Y2K-x/OpeN64-Ultra/(commit log)

2026-03-28 correct non-schematic parity DRC errors
    [OpeN64.kicad_sch]
2026-03-28 Start schematic rework - recreate RDRAM symbols
    [OpeN64.kicad_sch]
2026-03-28 fix reset switch symbol + footprint to correct DRC error
    [OpeN64.kicad_sch]
2026-04-13 update schematic symbols to conform more closely to KiCad standards
    [OpeN64.kicad_sch]
